RoboCupXelerators/robot-marker-tag/markers/aruco_4x4_50_id07_80mm.png

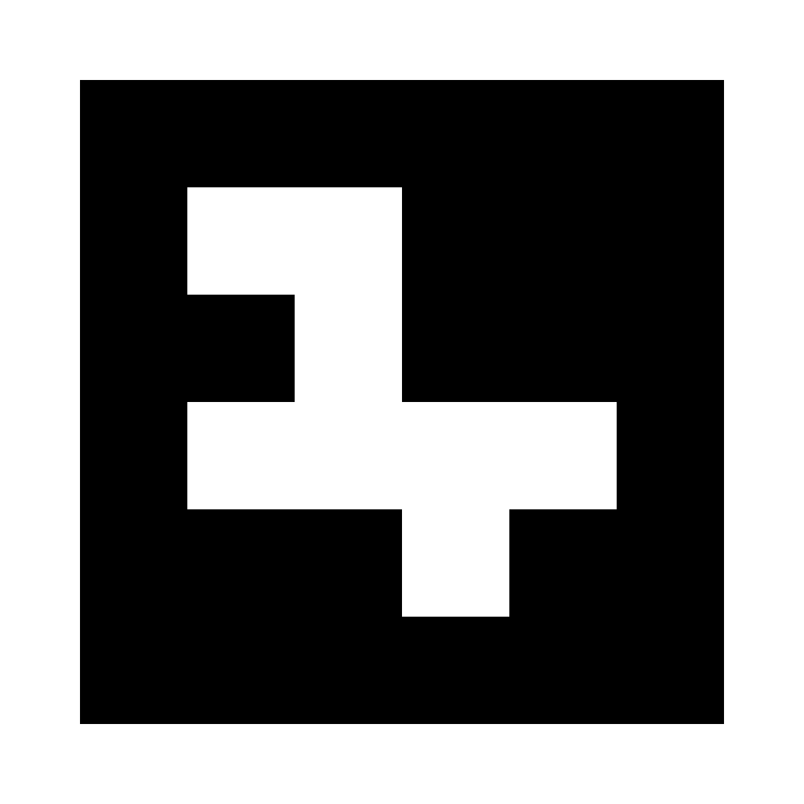
markers/aruco_4x4_50_id07_80mm.png
