RoboCupXelerators/robot-marker-tag/tag/preview_feature_bar.png

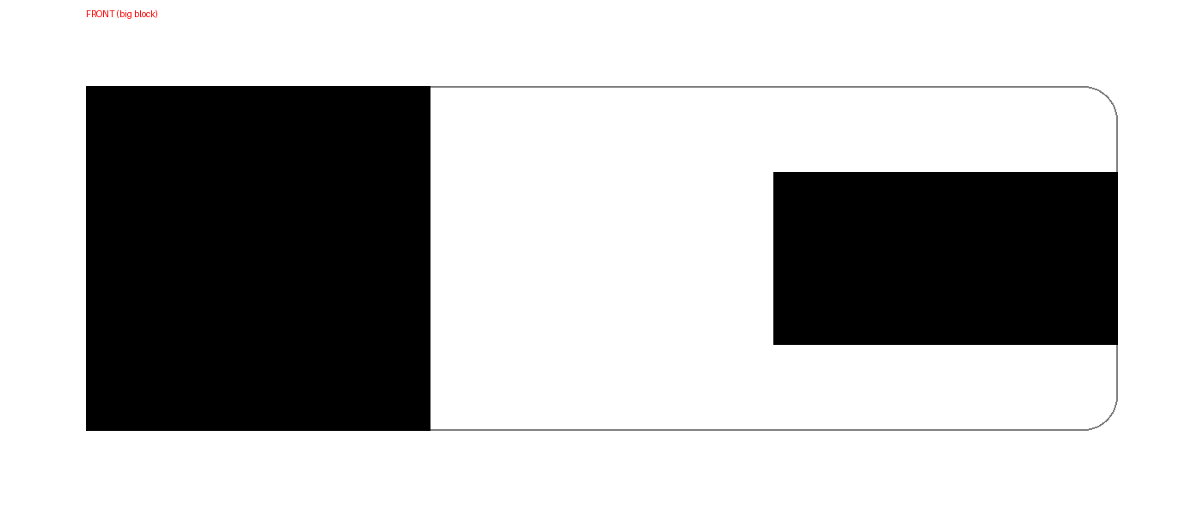
tag/preview_feature_bar.png
