RoboCupXelerators/robot-marker-tag/tag/preview_feature_pad.png

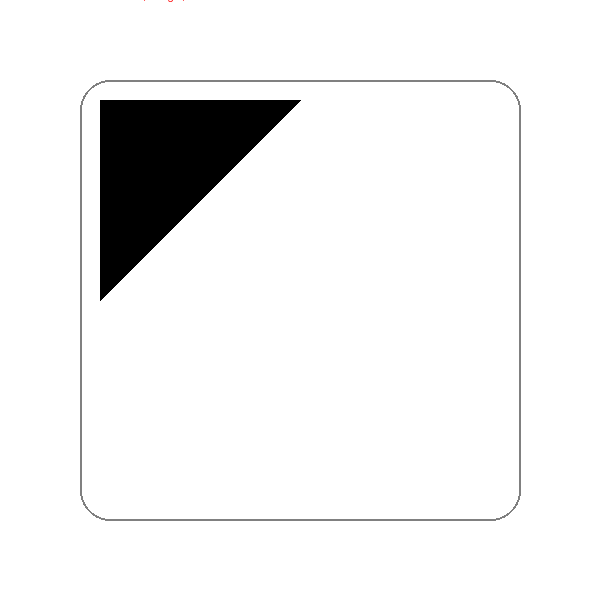
tag/preview_feature_pad.png
