RoboCupXelerators/robot-marker-tag/tag/handle_rod_129.5x14mm.3mf

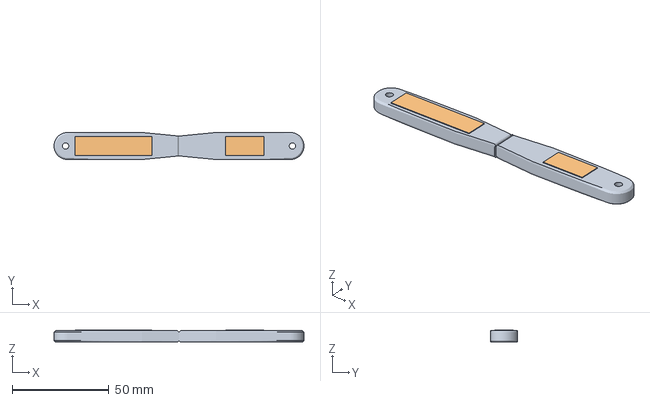
[picture p10: CAD file, 2026-11-04]
tag/handle_rod_129.5x14mm.3mf
129.5 x 14.0 x 6.30 mm
handle
front_knob
