RoboCupXelerators/robot-marker-tag/tag/ssl_pattern_d70_t44.3mf

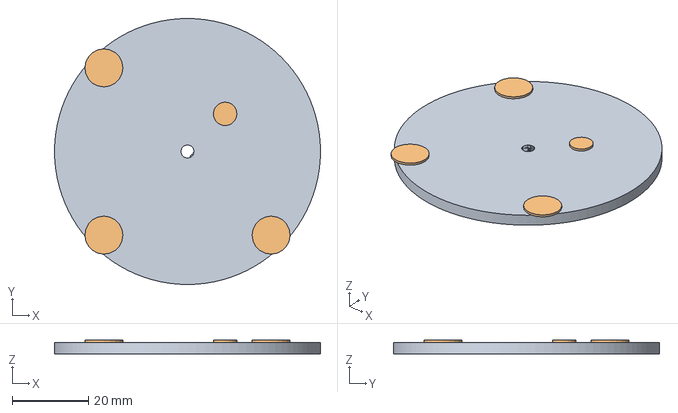
[picture p11: CAD file, 2026-11-04]
tag/ssl_pattern_d70_t44.3mf
70.0 x 70.0 x 3.60 mm
plate
dots
