RoboCupXelerators/robot-marker-tag/tag/ssl_pattern_d90_t60.3mf

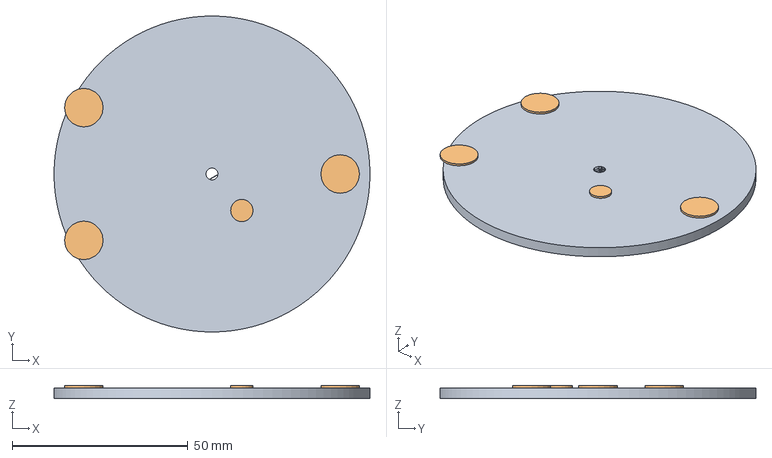
[picture p12: CAD file, 2026-11-04]
tag/ssl_pattern_d90_t60.3mf
90.0 x 90.0 x 3.60 mm
plate
dots
