RoboCupXelerators/robot-marker-tag/tag/ssl_pattern_d110_t60.3mf

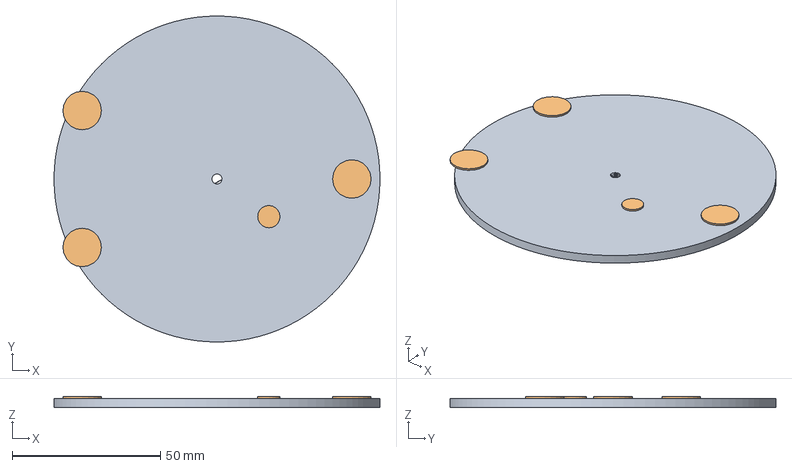
[picture p13: CAD file, 2026-11-04]
tag/ssl_pattern_d110_t60.3mf
110.0 x 110.0 x 3.60 mm
plate
dots
