RoboCupXelerators/robot-marker-tag/tag/handle_129.5x40mm.3mf

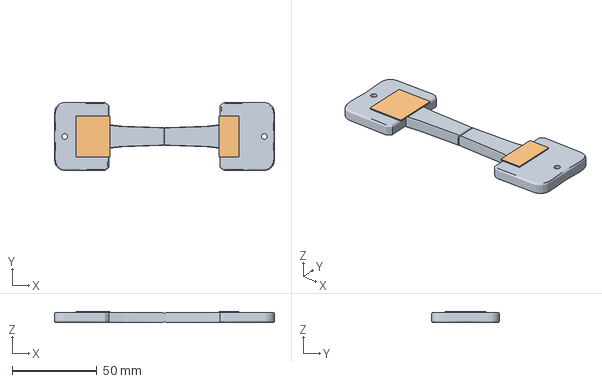
[picture p14: CAD file, 2026-11-04]
tag/handle_129.5x40mm.3mf
129.5 x 40.0 x 6.60 mm
handle
marker
