RoboCupXelerators/robot-marker-tag/tag/feature_bar_120x40mm.3mf

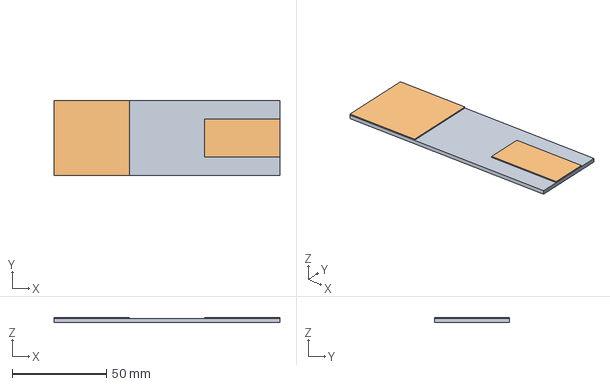
[picture p15: CAD file, 2026-11-04]
tag/feature_bar_120x40mm.3mf
120.0 x 40.0 x 2.60 mm
plate
feature
