RoboCupXelerators/robot-marker-tag/tag/feature_pad_40x40mm.3mf

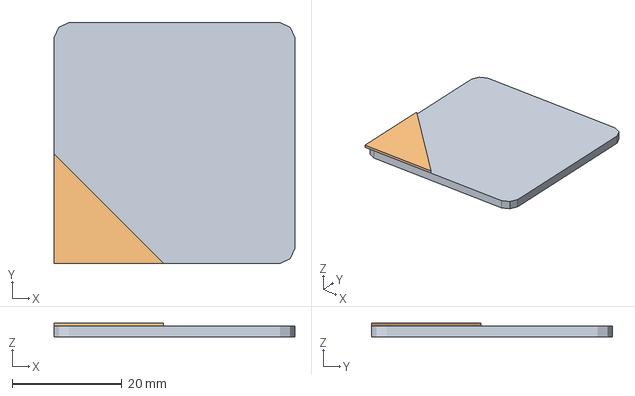
[picture p16: CAD file, 2026-11-04]
tag/feature_pad_40x40mm.3mf
44.0 x 44.0 x 2.60 mm
plate
feature
