RoboCupXelerators/robot-marker-tag/tag/aruco_4x4_50_id07_80mm.3mf

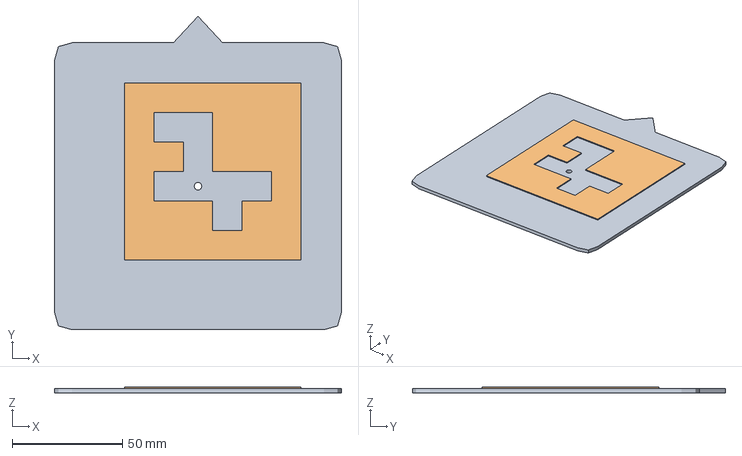
[picture p17: CAD file, 2026-11-04]
tag/aruco_4x4_50_id07_80mm.3mf
130.0 x 142.0 x 2.60 mm
plate
aruco_pattern
