RoboCupXelerators/robot-marker-tag/tag/aruco_4x4_50_id07_100mm.3mf

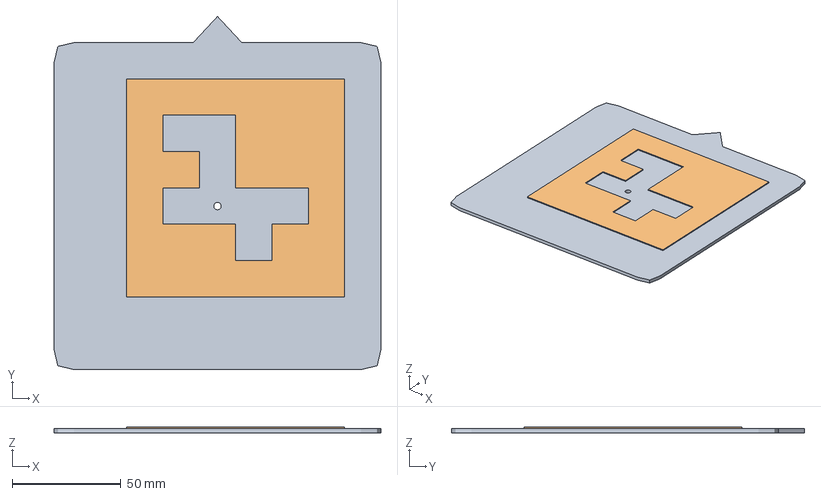
[picture p18: CAD file, 2026-11-04]
tag/aruco_4x4_50_id07_100mm.3mf
150.0 x 162.0 x 2.60 mm
plate
aruco_pattern
