RoboCupXelerators/robot-marker-tag/(commit log)

2026-11-04 ArUco 顶标：100/80mm 双色 3MF（拓竹）+ 300dpi PNG + 生成脚本
    4x4_50 / id 7，6x6 模块含黑边，底板 2mm、图案凸起 0.6mm、20mm 静区，
    +车头指示凸片；附解码朝向说明与换尺寸/换 ID 的生成命令。
    [aruco_4x4_50_id07_100mm.3mf, aruco_4x4_50_id07_80mm.3mf]
2026-11-04 顶标 v2：圆角 R6、中心 Ø3.4 M3 通孔（图案偏移半模块避开黑块）、三角车头凸片
    - save_3mf 改为带孔的圆角板环形网格 + 三角凸片棱柱
    - 新增校验：中孔必须落在白色模块内，否则拒绝生成
    - README/manifest 更新孔径、圆角、偏移量与安装方式
    [aruco_4x4_50_id07_100mm.3mf, aruco_4x4_50_id07_80mm.3mf]
2026-11-04 增加小空间方案：120x40 双色长条（推荐）与 40x40 角标（实验性）
    附分辨率换算：相机 3.25px/cm，40x40 只有 13px，ArUco 解不出；
    长条 120x40 为 39x13px，两端质心定方向误差约 1.5°。
    [feature_bar_120x40mm.3mf, feature_pad_40x40mm.3mf]
2026-11-04 提手一体件：129.5x40x6、孔距 117.5 / Ø3.3 不变、0.8mm 倒角、前 40x36 + 后 20x36 顶标
    两块黑色都避开两端孔位；孔壁为竖直圆柱，顶/底外缘 0.8mm 倒角避免割手。
    [handle_129.5x40mm.3mf]
2026-11-04 提手改成哑铃形：中间 12mm 握持段不变，两端加宽到 40mm 放标记
    之前整条 40mm 宽没法握。现在两端各 32.75mm 长、40mm 宽的垫子承载
    20x24 / 12x24 黑块，中间 12mm 宽可握；孔距 117.5、Ø3.3 不变，0.8mm 倒角保留。
    [handle_129.5x40mm.3mf]
2026-11-04 SSL 风格点阵板：Ø110 基线 93.9mm，理论朝向误差 1.9°
    圆盘点阵装在雷达顶，底边两点在后、单点在前标示车头，另加偏置小点消除 180° 歧义；
    另出 Ø90 版本（2.3°，略超）。README 附误差-基线换算与提高检测分辨率的建议。
    [ssl_pattern_d110_t60.3mf, ssl_pattern_d70_t44.3mf, ssl_pattern_d90_t60.3mf]
2026-11-04 提手兼标记：129.5x14x6 长条 + 前端 Ø22 圆钮
    按现有车的“杆+球”思路做成图纸尺寸：孔距 117.5/Ø3.3 不变、0.8mm 倒角；
    圆钮建议打黑色，长轴给朝向（~1°），圆钮给车头方向。
    [handle_rod_129.5x14mm.3mf]
2026-11-04 标记改为黑柄+红条：RCJ 禁止黄/蓝，红色对比最好
    前 40x10 / 后 20x10 红条（凸起 0.3mm），长轴给朝向、长度差给方向；
    README 补 RCJ 颜色规则与配色对比表。
    [handle_rod_129.5x14mm.3mf]
2026-11-04 颜色建议：白柄+品红标记（品红远离橙/蓝/绿/白，红色已被举报像橙）
2026-11-04 实拍测色：粉色在相机里接近白色（sat 0.19），建议改回白柄+黑标记
